DD4WH/SuperEars/Super_Ears_hardware_closup_DD4WH_20260320_233227.jpg

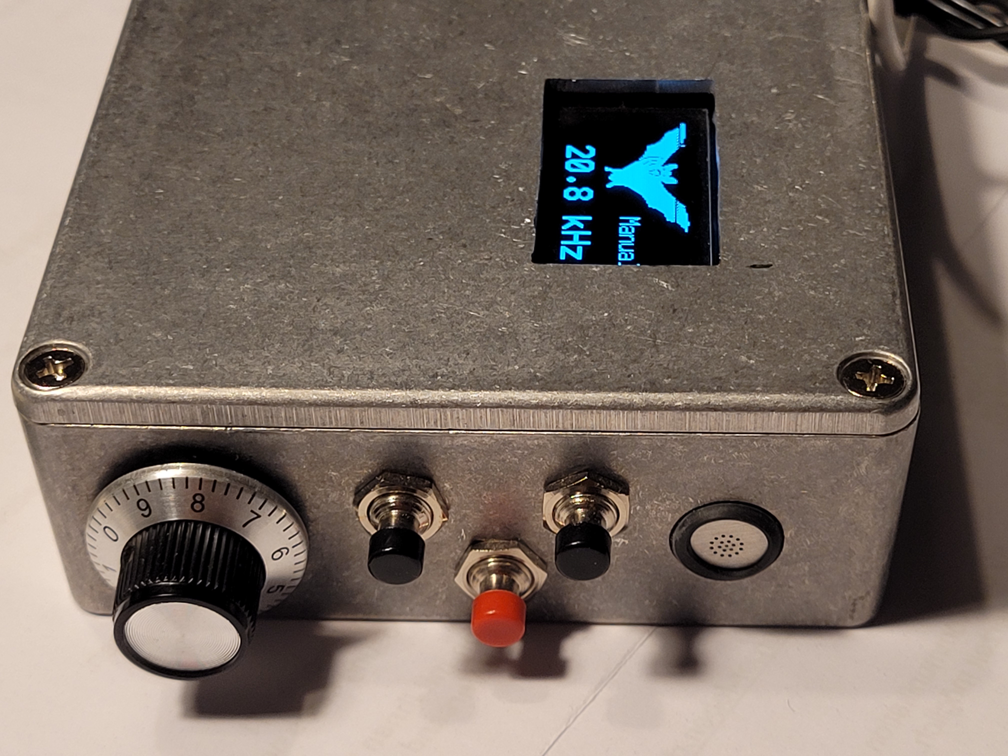
Super_Ears_hardware_closup_DD4WH_20260320_233227.jpg
