DD4WH/SuperEars/(commit log)

2026-02-22 added Manual Heterodyne mode
    * dynamic adjustment of Heterodyne frequency
    * repaired gain balance between pitch shift and heterodyne modes
    * switched to Bounce2 lib for buttons
2026-02-27 Add bitmaps and minor changes
    * added bird and bat bitmaps
    * clamped heterodyne frequency
    * changed appearance
2026-02-28 contrast adjustment & tweaks in appearance
    * added option to dim display
    * long press on push button now enables user to go back one mode
